KilowattSynthesis/Quadrifilar-Helix-Antenna-Frame-CAD/cad/twist_demo.scad

linear_extrude(height=60, twist=120, slices=60)
    circle(r=20, $fn=5);
