KilowattSynthesis/Quadrifilar-Helix-Antenna-Frame-CAD/(commit log)

2026-06-03 feat: Print inputs in calculator example
2026-06-03 feat: Add CAD constructor
2026-06-03 tiny: Add twist demo model
    [twist_demo.scad]
2026-06-03 feat: Start drawing antenna geometry from scratch
2026-06-07 refactor: Polish the wire generator
2026-06-11 feat: Use wire model to subtract from frame
2026-09-02 feat: Rework frame for foil tape, zip ties, balun PCB, and mast
    Replace the wire channels with plain twisted blades whose flat outer end
    faces are tape lands: the conductor is now self-adhesive foil tape stuck
    to the outside, so there is nothing to thread. The end faces sit exactly
    on the RF design radius, so the tape lands where the solver wants it.
    - Zip-tie holes through each blade near its ends and near the top/bottom
    bars, so a tie can wrap the edge over the tape as adhesive backup.
    - Mast sleeve bored for 1.5 in (38.1 mm) OD PVC pipe, with radial screw
    holes into the pipe. Optional (mast_pipe_od=None) for antennas too
    small to straddle a pipe -- the 913 MHz build is one.
    - Balun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
2026-09-02 feat: Add a fourth PCB standoff for symmetry
    The QFHBAL01 has three mounting holes and an RF connector in the fourth
    quadrant, so the boss at 315 deg goes unused -- it just backs up the board
    under the connector side, and lets the board be fitted in any of the four
    rotations.
    Claude-Session: https://claude.ai/code/session_01KRziZpcajxB4Ew9srFprnM
2026-09-02 fix: Add bottom tape pass-throughs into the PCB housing
    The mast sleeve's wall rises to z=0, straight across the path each tape run
    takes inboard along the blade's underside, so the tape had no way to reach
    the board. Cut a 20 x 10 mm window through the wall at each of the four
    bars, its roof flush with that underside, so the tape crosses into the
    housing and drops onto the pads.
    Sized against the standoff (the window has to be at least as deep, or the
    tape cannot reach the board) and against the sleeve circumference (the
    windows must not eat so much wall that the pillars between them go).
    Claude-Session: https://claude.ai/code/session_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
2026-09-02 feat: Flare the blade section so only the tape lands are full width
    The twisted section was a plain rectangle at the full tape land width for
    its whole length. Make it a thin blade_core_thickness (5 mm) core that
    flares out over the last tape_land_flare_length (10 mm) at each end to the
    full tape_land_width (10 mm, up from 8 mm), so the tape still gets a wide
    land to stick to but the material is not spent along the whole blade.
    45% less section area than a plain 10 mm slab; the 436 MHz frame drops from
    356 to 255 cm^3. The flat top and bottom faces are now core width, so tape
    turning inboard there overhangs a little.
    Claude-Session: htt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
2026-09-02 feat: Add full-width tape lands; swap PCB slots for wire feed-throughs
    The flare only widened the blade radially, leaving the flat top and bottom
    faces at core width with the tape overhanging them. Make the top and bottom
    tape_pad_thickness (3 mm) of every blade a full tape_land_width x rad land.
    Build the blade as a stack of three twisted segments -- land, flared core,
    land -- rather than laying pad solids over a full-height core. Overlapping
    them makes the pad's end faces touch the core's flared end faces
    tangentially, which left the 913 MHz part non-manifold. For the same reason
    the crossover window is cut from the bare core with the cutter overshooting
    its top face, so the top land clos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
2026-09-02 feat: Widen PCB feed-throughs to 2.5 mm, 1 mm under the tape surface
    Derive the hole's depth from a new pcb_wire_hole_edge_margin (1.0 mm)
    measured to the near edge rather than fixing the axis depth, so the hole
    stays put against the tape surface if the diameter changes. Verified on the
    built solid: top edge at exactly z=-1.000.
    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
2026-09-02 feat: Split tall frames into printable sections joined by pins and ties
    Frames taller than max_print_height (default 200 mm) are now cut into as few
    equal horizontal sections as will fit. The pins that stand proud of each cut
    count against the budget, so a section really does fit the bed. Set
    max_print_height=None to keep the frame in one piece.
    Each joint is a boss on the axis, where both blades cross, so it ties them
    together. It carries two locating pins; two is enough to fix the orientation
    because a blade is symmetric under a half turn about Z, making the only other
    orientation the pins allow the identical one. The boss is a cone below the
    cut and a cylinder above it, so neither sectio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
2026-09-03 feat: Make joint pins 3 mm balls, on the arms as well as the axis
    Balls sit on the cut plane, half proud of the section below and half dished
    into the one above, and self-centre as the joint closes.
    Reaching only their own radius above the plane is also what lets pins go out
    on the arms at all: the blade turns as it rises, so a pin standing any real
    height out there would twist straight out the side of the 5 mm core -- an
    8 mm pin at r=40 drifted about 4.4 mm. A 3 mm ball needs at most 1.7 mm of
    half-thickness anywhere on its surface, well inside the core, so pins now go
    on both blades' arms as well as the axial pair.
    Sockets are cut after the split, unlike the boss and tie holes: a ball
    s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
2026-09-03 feat: Move joint balls to the section above each cut
    Adds joint_balls_on_lower_section (default False) to pick the side. With the
    balls above, the section below each cut is left with a dish that opens
    upward, which is about the easiest feature there is to print.
    The trade comes at the other end of the joint: the balls hang below their own
    section's mating face, so those sections want flipping on the bed. Printed as
    modelled, the mating face is a 1.35 mm overhang resting on ten ball tips.
    The bottom-most section is unaffected -- it carries only a dish. The code
    logs this at build time, and setting the flag True restores the previous
    arrangement, where every section prints as modelled but the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
2026-09-03 feat: Beef up the base -- 6 mm bottom land, 8 mm mast sleeve wall
    The bottom full-width land now runs up to the outside top of the PCB
    enclosure rather than stopping at tape_pad_thickness, so the base of the
    antenna is one solid 10 mm-wide slab flush with the hub instead of a 3 mm
    land sitting on a 5 mm core. Derived from hub_plate_thickness via
    bottom_land_thickness, so it tracks the hub if that changes. The top land is
    untouched at 3 mm -- it carries no load.
    Double the mast sleeve wall to 8 mm; the outer radius goes 23.25 -> 27.25,
    still well clear of the tape lands at r=47.45. That sleeve is the joint the
    whole antenna hangs off.
    Measured on the built solid: full 10 mm width holds to z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
2026-09-03 fix: Show only the 436 MHz build, its two sections side by side
    The viewer was being handed one part per show() call, and show() replaces
    what is displayed, so the render was whichever part happened to be last --
    the 913 MHz one. Pass them in a single call instead, filtered to the 436 MHz
    sections and laid out side by side on the bed with a 20 mm gap, so both are
    visible at once rather than stacked into a 267 mm tower.
    Only what is displayed changes; all three parts are still exported.
    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
2026-09-03 Add way more screws at the bottom
2026-09-03 config: Move holes on sleeve apart
2026-09-03 feat: Change joint boss to be cone on both sides
2026-09-08 fix: Rearrange feed PCB height for wires
2026-09-08 refactor: Move the tape frame into its own module
    The frame on this branch is a foil-tape design that shares almost nothing
    with the wire-channel frame it grew out of -- only about 6% of the original
    file survives, well under git's rename threshold -- so it belongs under its
    own name rather than as a rewrite of qfh_frame_cad.py.
    Content-identical move, kept on its own so git reads it as a plain rename
    without needing copy detection.
    Claude-Session: https://claude.ai/code/session_019r8wN99yyP1xX5DBRasK5p
2026-09-08 docs: Point the README at the renamed tape frame module
    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
2026-09-08 revert: Restore the wire-channel frame under its old name
    The tape frame moved to qfh_tape_frame_cad.py, which left this branch
    deleting the wire-channel design it grew out of. Put it back untouched, as
    it stood before the branch, so the two frames live side by side and the
    branch reads as purely additive.
    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
2026-09-10 feat: Export single-unit tape frame (uncut) too
2026-09-10 config: Decrease screw hole count at bottom
2026-09-24 fix: Adjust PCB height for easier soldering
2026-09-29 fix: Use proper wire diameter and bend radius in CAD
2026-09-29 fix: Z position of PCB relative to mast
